eawade7/Death_Ray_OSU_Capstone/README.md

# Death_Ray_OSU_Capstone

Demonstration Videos
https://youtu.be/gTWwTbxBq3s

Explanation of Engineering Specifications
https://youtu.be/X_xn40_CjBk
