eawade7/Death_Ray_OSU_Capstone/Pictures/Copy of 20221027_112926.jpg

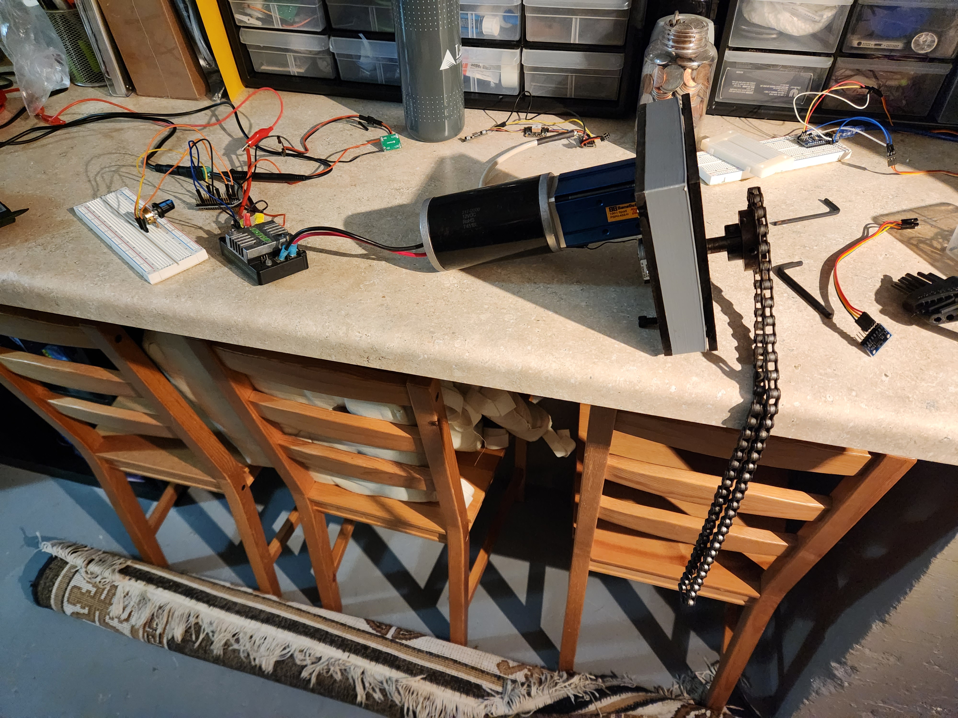
Pictures/Copy of 20221027_112926.jpg
