eawade7/Death_Ray_OSU_Capstone/Pictures/Copy of 20221205_194728.jpg

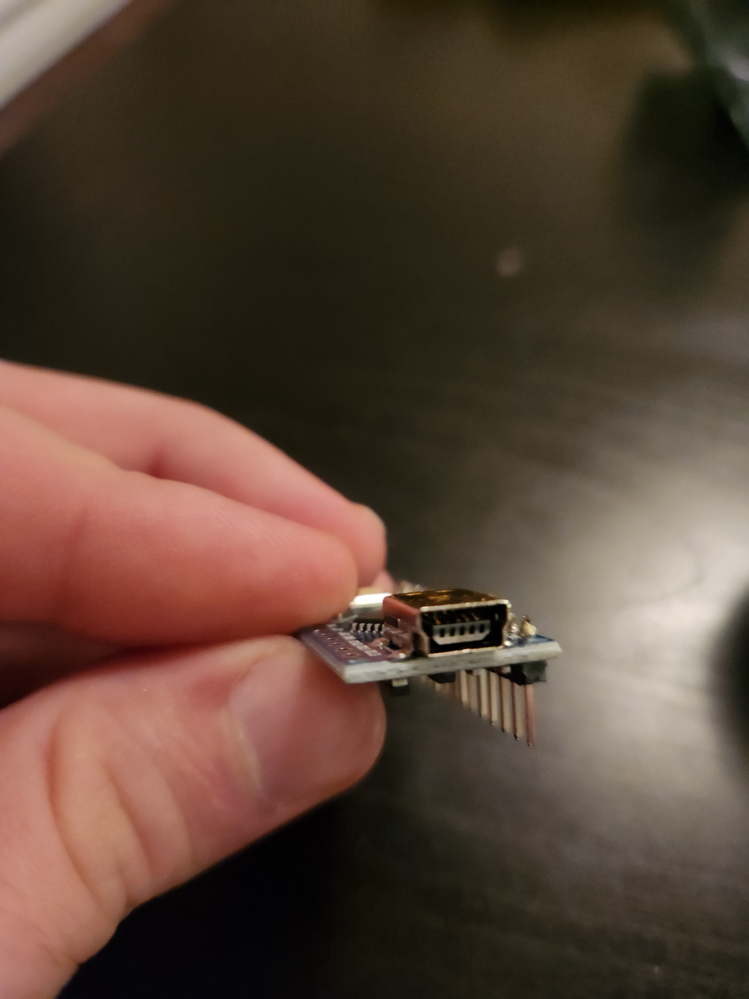
Pictures/Copy of 20221205_194728.jpg
