eawade7/Death_Ray_OSU_Capstone/Pictures/Copy of 20221206_010354.jpg

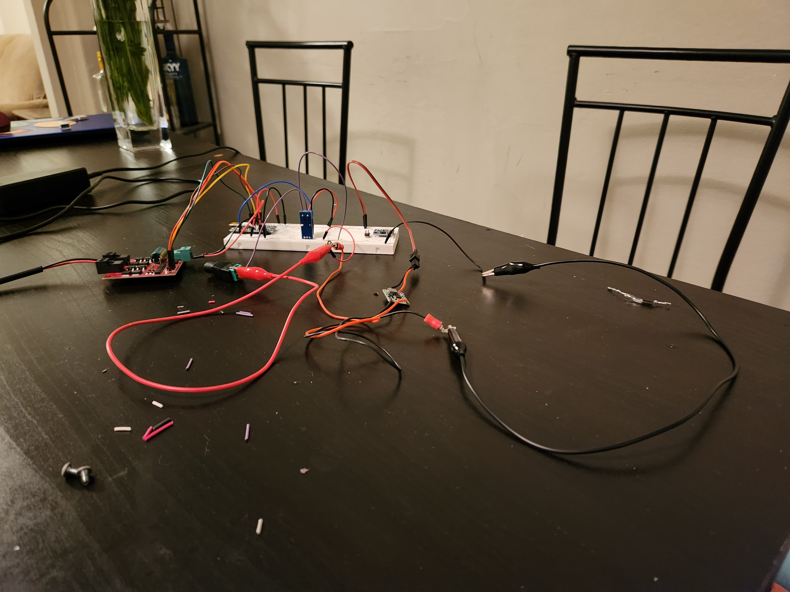
Pictures/Copy of 20221206_010354.jpg
