eawade7/Death_Ray_OSU_Capstone/Pictures/Copy of 20230210_131838.jpg

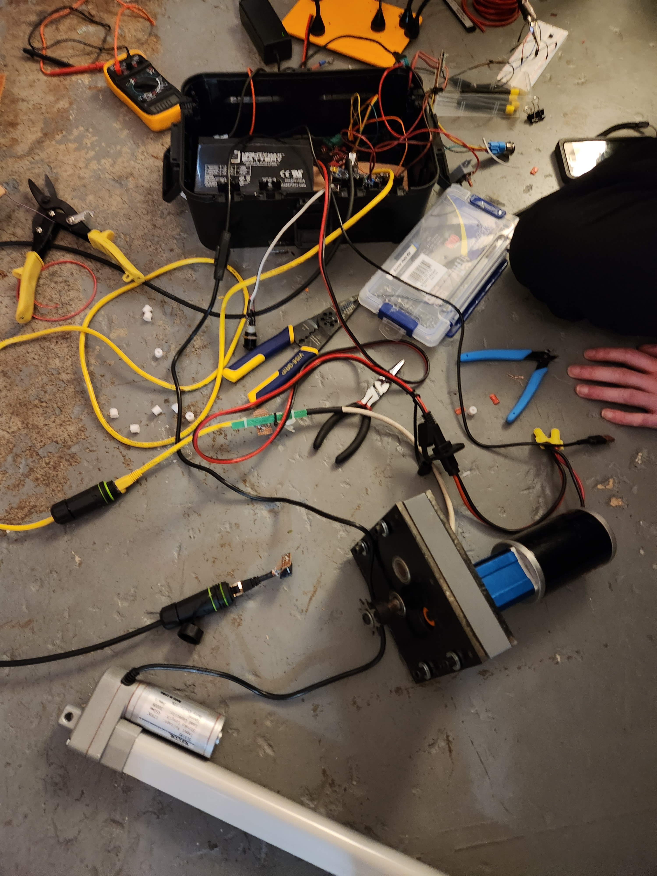
Pictures/Copy of 20230210_131838.jpg
