eawade7/Death_Ray_OSU_Capstone/Pictures/Copy of 20230301_172952.jpg

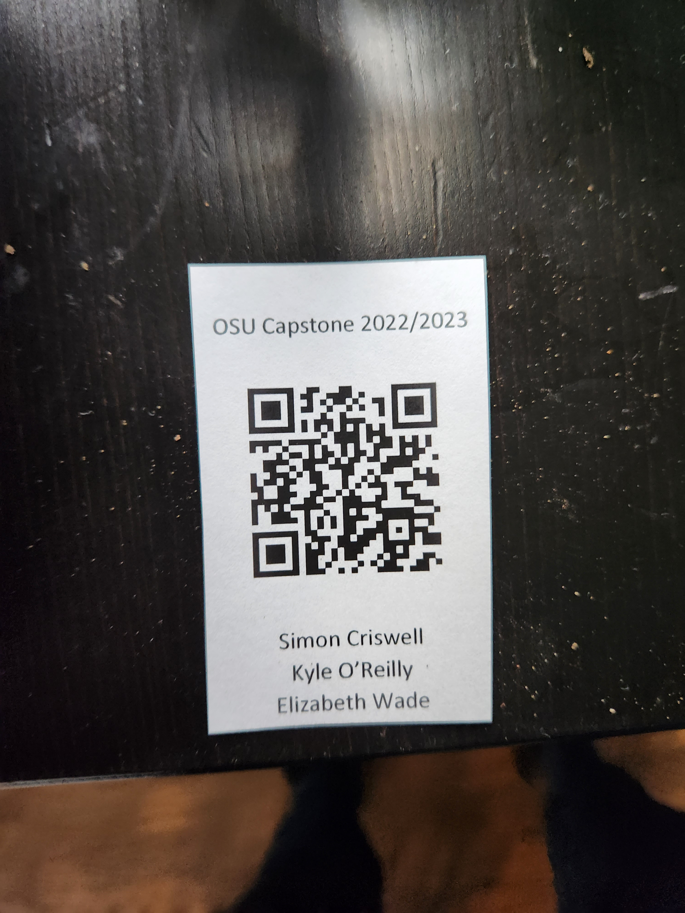
Pictures/Copy of 20230301_172952.jpg
