eawade7/Death_Ray_OSU_Capstone/Pictures/Copy of Screenshot_20221130_054740.png

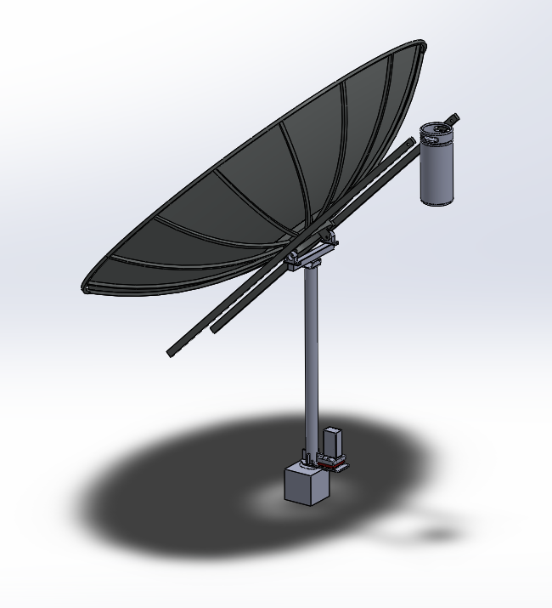
Pictures/Copy of Screenshot_20221130_054740.png
