eawade7/Death_Ray_OSU_Capstone/Pictures/Copy of Screenshot_20221130_102814.png

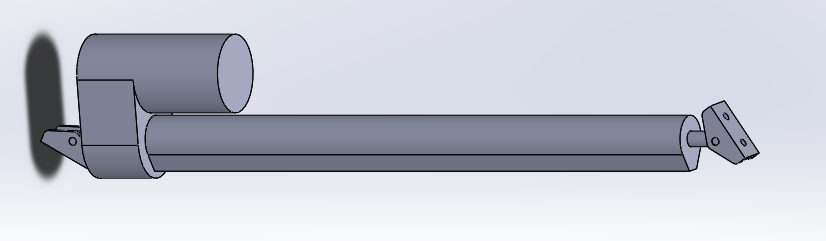
Pictures/Copy of Screenshot_20221130_102814.png
