eawade7/Death_Ray_OSU_Capstone/Final Bill of Materials.xlsx

Full Project BOM
No. | Project Block | Old vs. New Capstone | Item Name | Qty | Vendor | Link | Price per Unit | Total Cost
1 | Tilt | New | Heavy Duty 3000N/660lbs Linear Actuator | 1 | Amazon | Recoil Link (https://www.amazon.com/RECOIL-Actuator-Mounting-Reversing-Momentary/dp/B09BCN81G8) | 66 | 66
2 | Tilt | New | Actuator controller | 1 | Amazon | Linear Actuator Controller (https://www.amazon.com/dp/B071NQ5G71?psc=1&smid=A298K45OP416LP&ref_=chk_typ_imgToDp) | 17 | 17
3 | Power | Old | Battery | 1 | N/A | N/A |  | 0
4 | Comp | New | Accelerometer/Compass chip | 1 | Amazon | Accelerometer Link (https://www.amazon.com/AITRIP-LSM303DLHC-Compass-Acceleration-Magnetometer/dp/B09YQWXK16) | 9.99 | 9.99
5 | Comp | New | Arduino | 1 | AliExpress | Arduino Link (https://www.aliexpress.us/item/2255799923112796.html?curPageLogUid=DR0uJFqDSp4T) | 35 | 35
6 | Comp | New | Current Measuring Device | 1 | Amazon | Current Measuring Link (https://www.amazon.com/HiLetgo-ACS712-Current-Sensor-Module/dp/B07SPRL8DL?s=industrial) | 7.39 | 7.39
7 | Testing | New | Multimeter | 1 | Amazon | Multimeter Link (https://www.amazon.com/dp/B01ISAMUA6?psc=1&smid=A2NOFZGOKNP3PJ&ref_=chk_typ_imgToDp) | 12.99 | 12.99
8 | Tilt/Pan | New | Dual Motor Controller | 1 | Amazon | Motor Controller Link (https://www.amazon.com/DROK-Controller-Regulator-Industrial-Optocoupler/dp/B06XGD5SCB) | 15.78 | 15.78
9 | Power | New | Self-Resetting Fuse | 1 | Amazon | Self-Reseting Fuse Link (https://www.amazon.com/gp/product/B08P6Z5FZJ/ref=ox_sc_act_title_4?smid=A2ZNPLJCY5BQIU&th=1) | 10.97 | 10.97
10 | Power | New | Toggle Switch | 1 | Amazon | Toggle Switch Link (https://www.amazon.com/gp/product/B07QNPTXSW/ref=ox_sc_act_title_1?smid=A86AD06S3OMVQ&psc=1) | 8.99 | 8.99
11 | Comp | New | Push Button | 1 | Amazon | Push Button Link (https://www.amazon.com/gp/product/B07JH9DKLQ/ref=ox_sc_act_title_2?smid=A1792RTTLO6S27&psc=1) | 7.99 | 7.99
12 | Pan | Old | Motor | 1 | N/A | N/A |  | 0
13 | Pan | Old | Motor Controller | 1 | N/A | N/A |  | 0
14 | Power | Old | Voltage Regulator | 1 | N/A | N/A |  | 0
15 | Comp | Old | GPS computer chip | 1 | N/A | N/A |  | 0
16 | Comp | Old | Data Storage computer chip | 1 | N/A | N/A |  | 0
17 | Pan | Old | Encoder | 1 | N/A | N/A |  | 0
18 | Pan | New | small gear | 1 | Mcmaster | Roller Chain Sprocket, for ANSI 41 Chain, 8 Teeth, for 1/2" Shaft Diameter | McMaster-Carr (https://www.mcmaster.com/2737T93/) | 22.7 | 22.7
19 | Power | New | Enclosure | 1 | Amazon | Link (https://www.amazon.com/cart/smart-wagon?newItems=4745eed2-cb6d-4a0e-9c97-382a352b51a4,1) | 26.99 | 26.99
20 | Power | New | Ethernet Coupler | 1 | Amazon | Link (https://www.amazon.com/gp/product/B08CDD2BRF/ref=ox_sc_act_title_2?smid=A3CX0D8X6MF77E&psc=1) | 13.99 | 13.99
21 | Power | New | Ethernet Cord | 1 | Amazon | Link (https://www.amazon.com/gp/product/B07QLXC6QR/ref=ewc_pr_img_1?smid=A2WC0H630DY40C&th=1) | 8.99 | 8.99
22 | Power | New | Solar Module | 1 | Amazon | Link (https://www.amazon.com/gp/product/B07K687B2D/ref=ox_sc_act_title_1?smid=A2EH5PO307BR7O&psc=1) | 33.5 | 33.5
23 | Power | New | wire nut | 1 | home depot | - | 3.98 | 3.98
24 | Power | New | 5/8 drill bit | 1 | home depot | - | 9.97 | 9.97
25 | Pan | New | PETG filament | 1 | Amazon | Link (https://www.amazon.com/HATCHBOX-3D-Filament-Dimensional-Accuracy/dp/B014VM991I) | 24.99 | 24.99
26 | Misc | New | wires | 1 | Amazon | Link (https://www.amazon.com/TUOFENG-Hookup-Wires-6-Different-Colored/dp/B07TX6BX47) | 14.99 | 14.99
27 | Power | New | Trickle Charger | 1 | Amazon | Link (https://www.amazon.com/dp/B07CZ7KWP3?psc=1&smid=A2KZI50HSCBYG9&ref_=chk_typ_imgToDp) | 17.96 | 17.96
 |  |  |  |  |  |  | Total | 353.16
