eawade7/Death_Ray_OSU_Capstone/Wiring_Diagram.pdf

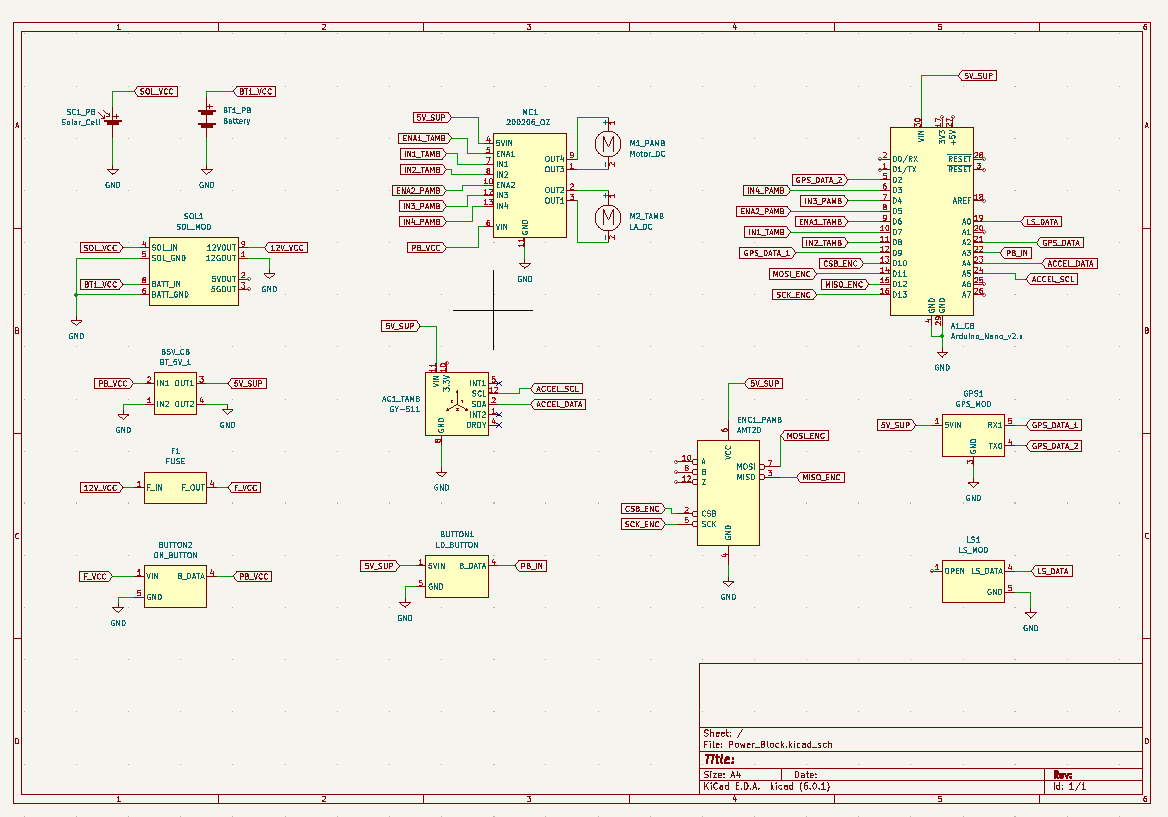
[picture p74: page 1]
