eawade7/Death_Ray_OSU_Capstone/NEW_GENERAL_DOC_DeathRayDrawing_02.pdf

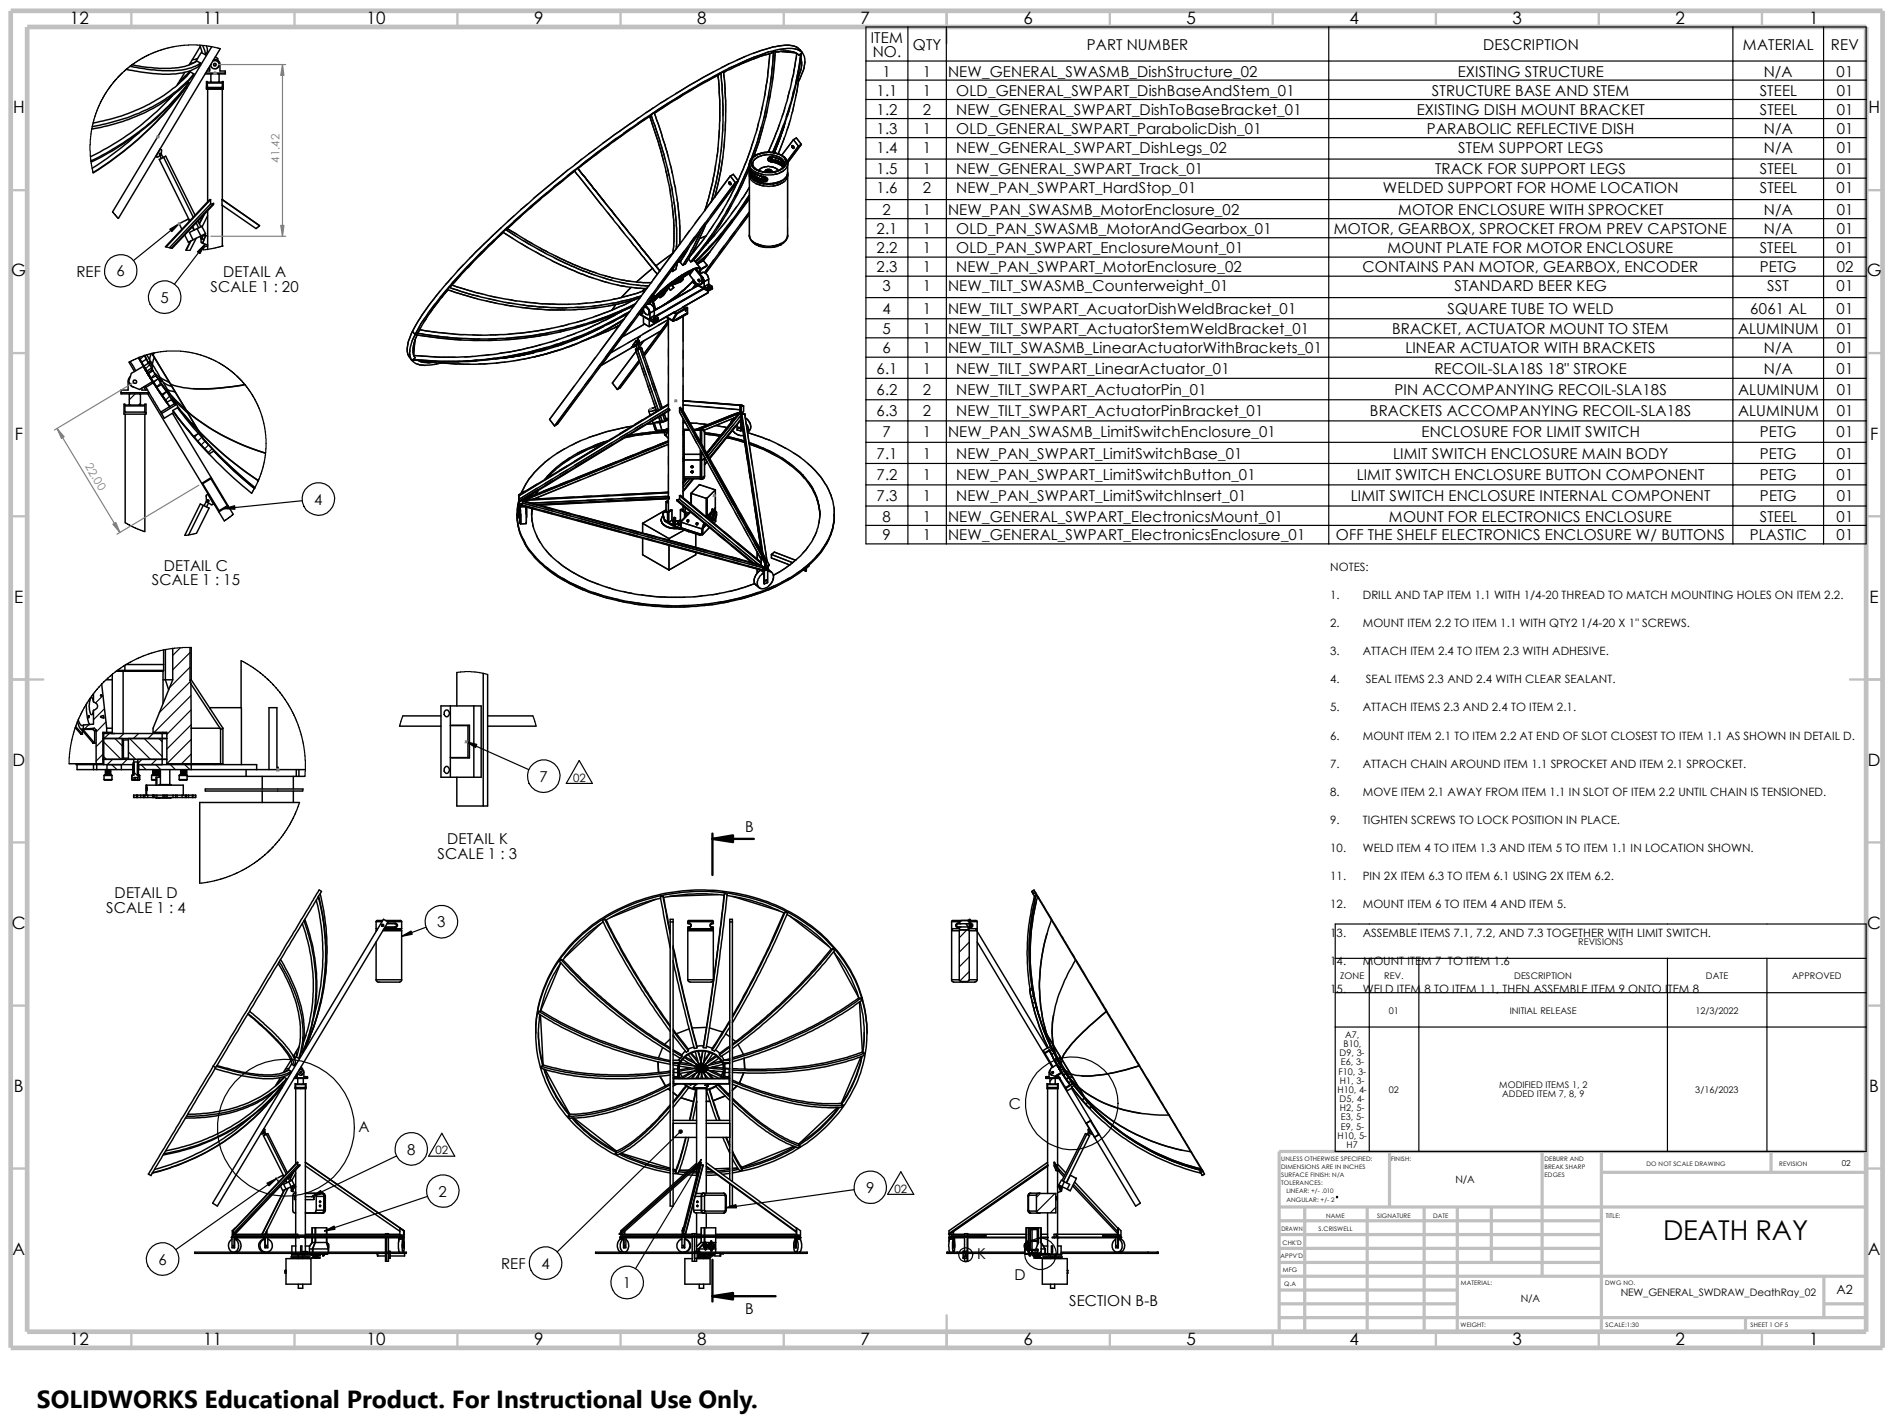
[picture p75: page 1]
FINISH:; DEBURR AND; BREAK SHARP EDGES; DO NOT SCALE DRAWING; REVISION; SCALE:1:30; SHEET 1 OF 5; WEIGHT:; DETAIL A SCALE 1 : 20; REF 6; SECTION B-B; ITEM; NO. QTY; PART NUMBER; DESCRIPTION; MATERIAL REV; 1 NEW_GENERAL_SWASMB_DishStructure_02; EXISTING STRUCTURE; OLD_GENERAL_SWPART_DishBaseAndStem_01; STRUCTURE BASE AND STEM; STEEL; NEW_GENERAL_SWPART_DishToBaseBracket_01; EXISTING DISH MOUNT BRACKET; OLD_GENERAL_SWPART_ParabolicDish_01; PARABOLIC REFLECTIVE DISH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

1. DRILL AND TAP ITEM 1.1 WITH 1/4-20 THREAD TO MATCH MOUNTING HOLES ON ITEM 2.2.

2. MOUNT ITEM 2.2 TO ITEM 1.1 WITH QTY2 1/4-20 X 1" SCREWS.

3. ATTACH ITEM 2.4 TO ITEM 2.3 WITH ADHESIVE.

4. SEAL ITEMS 2.3 AND 2.4 WITH CLEAR SEALANT.

5. ATTACH ITEMS 2.3 AND 2.4 TO ITEM 2.1.

6. MOUNT ITEM 2.1 TO ITEM 2.2 AT END OF SLOT CLOSEST TO ITEM 1.1 AS SHOWN IN DETAIL D.

7. ATTACH CHAIN AROUND ITEM 1.1 SPROCKET AND ITEM 2.1 SPROCKET.

8. MOVE ITEM 2.1 AWAY FROM ITEM 1.1 IN SLOT OF ITEM 2.2 UNTIL CHAIN IS TENSIONED.

9. TIGHTEN SCREWS TO LOCK POSITION IN PLACE.

10. WELD ITEM 4 TO ITEM 1.3 AND ITEM 5 TO ITEM 1.1 IN LOCATION SHOWN.

11. PIN 2X ITEM 6.3 TO ITEM 6.1 USING 2X ITEM 6.2.

12. MOUNT ITEM 6 TO ITEM 4 AND ITEM 5.

13. ASSEMBLE ITEMS 7.1, 7.2, AND 7.3 TOGETHER WITH LIMIT SWITCH.

14. MOUNT ITEM 7 TO ITEM 1.6
15. WELD ITEM 8 TO ITEM 1.1, THEN ASSEMBLE ITEM 9 ONTO ITEM 8

UNLESS OTHERWISE SPECIFIED:
DIMENSIONS ARE IN INCHES
SURFACE FINISH: N/A
TOLERANCES:
LINEAR: +/- .010
ANGULAR: +/- 2

NAME | SIGNATURE | DATE | | | | TITLE: DEATH RAY

DRAWN | S.CRISWELL
CHK'D
APPV'D

MFG
Q.A | | | | MATERIAL: | DWG NO. NEW_GENERAL_SWDRAW_DeathRay_02 | A2 N/A

SOLIDWORKS Educational Product. For Instructional Use Only.

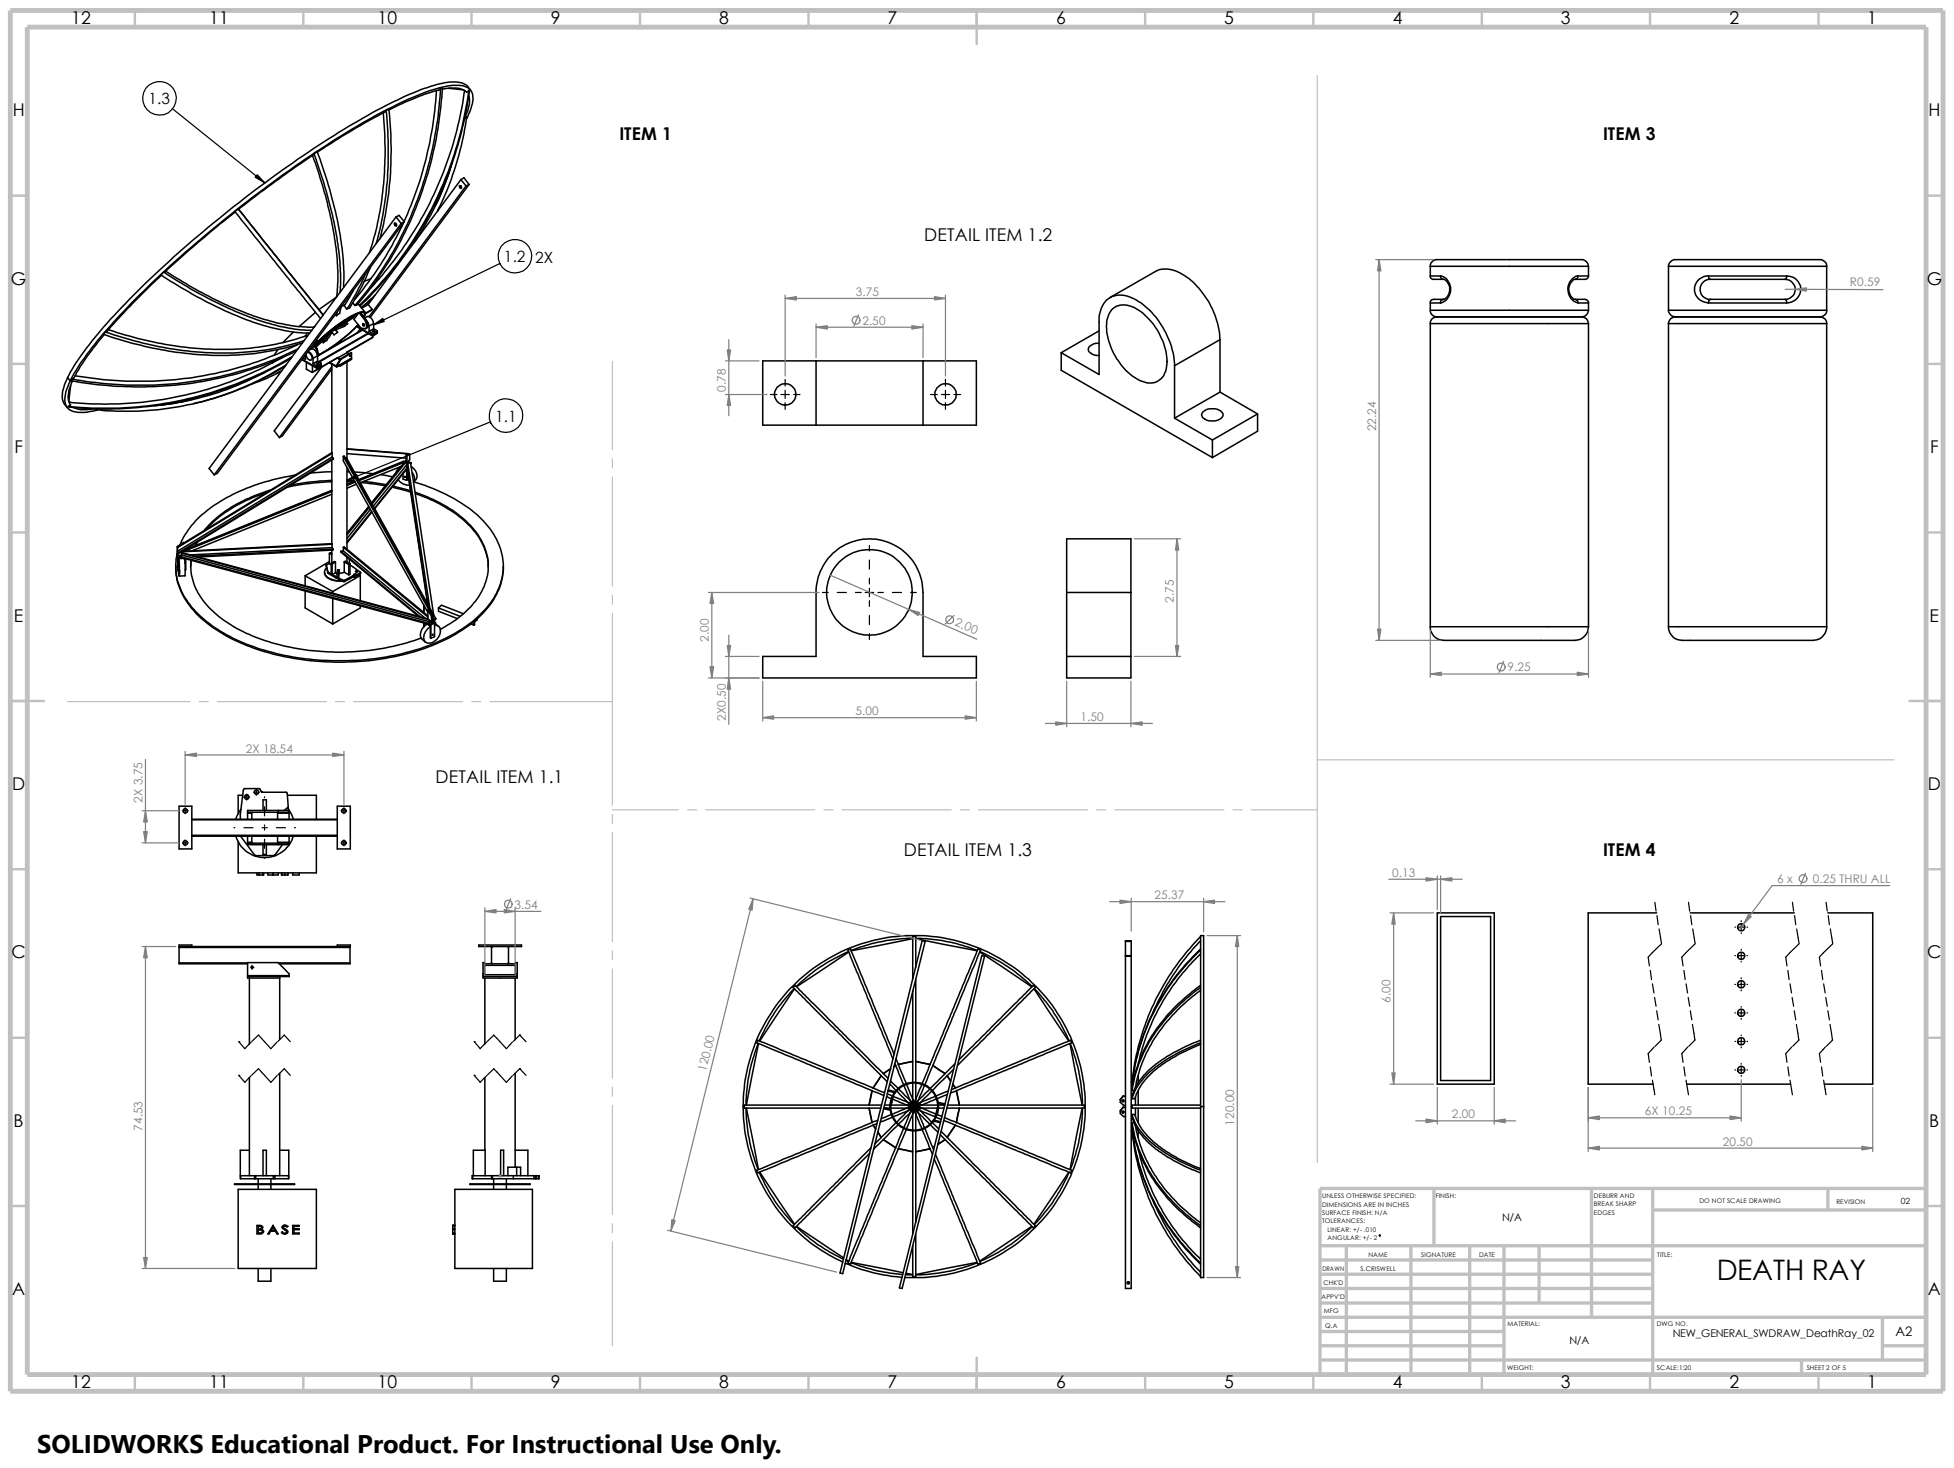
[picture p76: page 2]
FINISH:; DEBURR AND; BREAK SHARP EDGES; DO NOT SCALE DRAWING; REVISION; SCALE:1:20; SHEET 2 OF 5; ITEM 1; DETAIL ITEM 1.1; DETAIL ITEM 1.3; DETAIL ITEM 1.2; ITEM 3; ITEM 4; 0.25 THRU ALL

UNLESS OTHERWISE SPECIFIED:
DIMENSIONS ARE IN INCHES
SURFACE FINISH: N/A
TOLERANCES:
LINEAR: +/- .010
ANGULAR: +/- 2

NAME | SIGNATURE | DATE | | | | TITLE: DEATH RAY

DRAWN | S.CRISWELL
CHK'D
APPV'D

MFG
Q.A | | | | MATERIAL: | DWG NO. NEW_GENERAL_SWDRAW_DeathRay_02 | A2 N/A

M 7.19

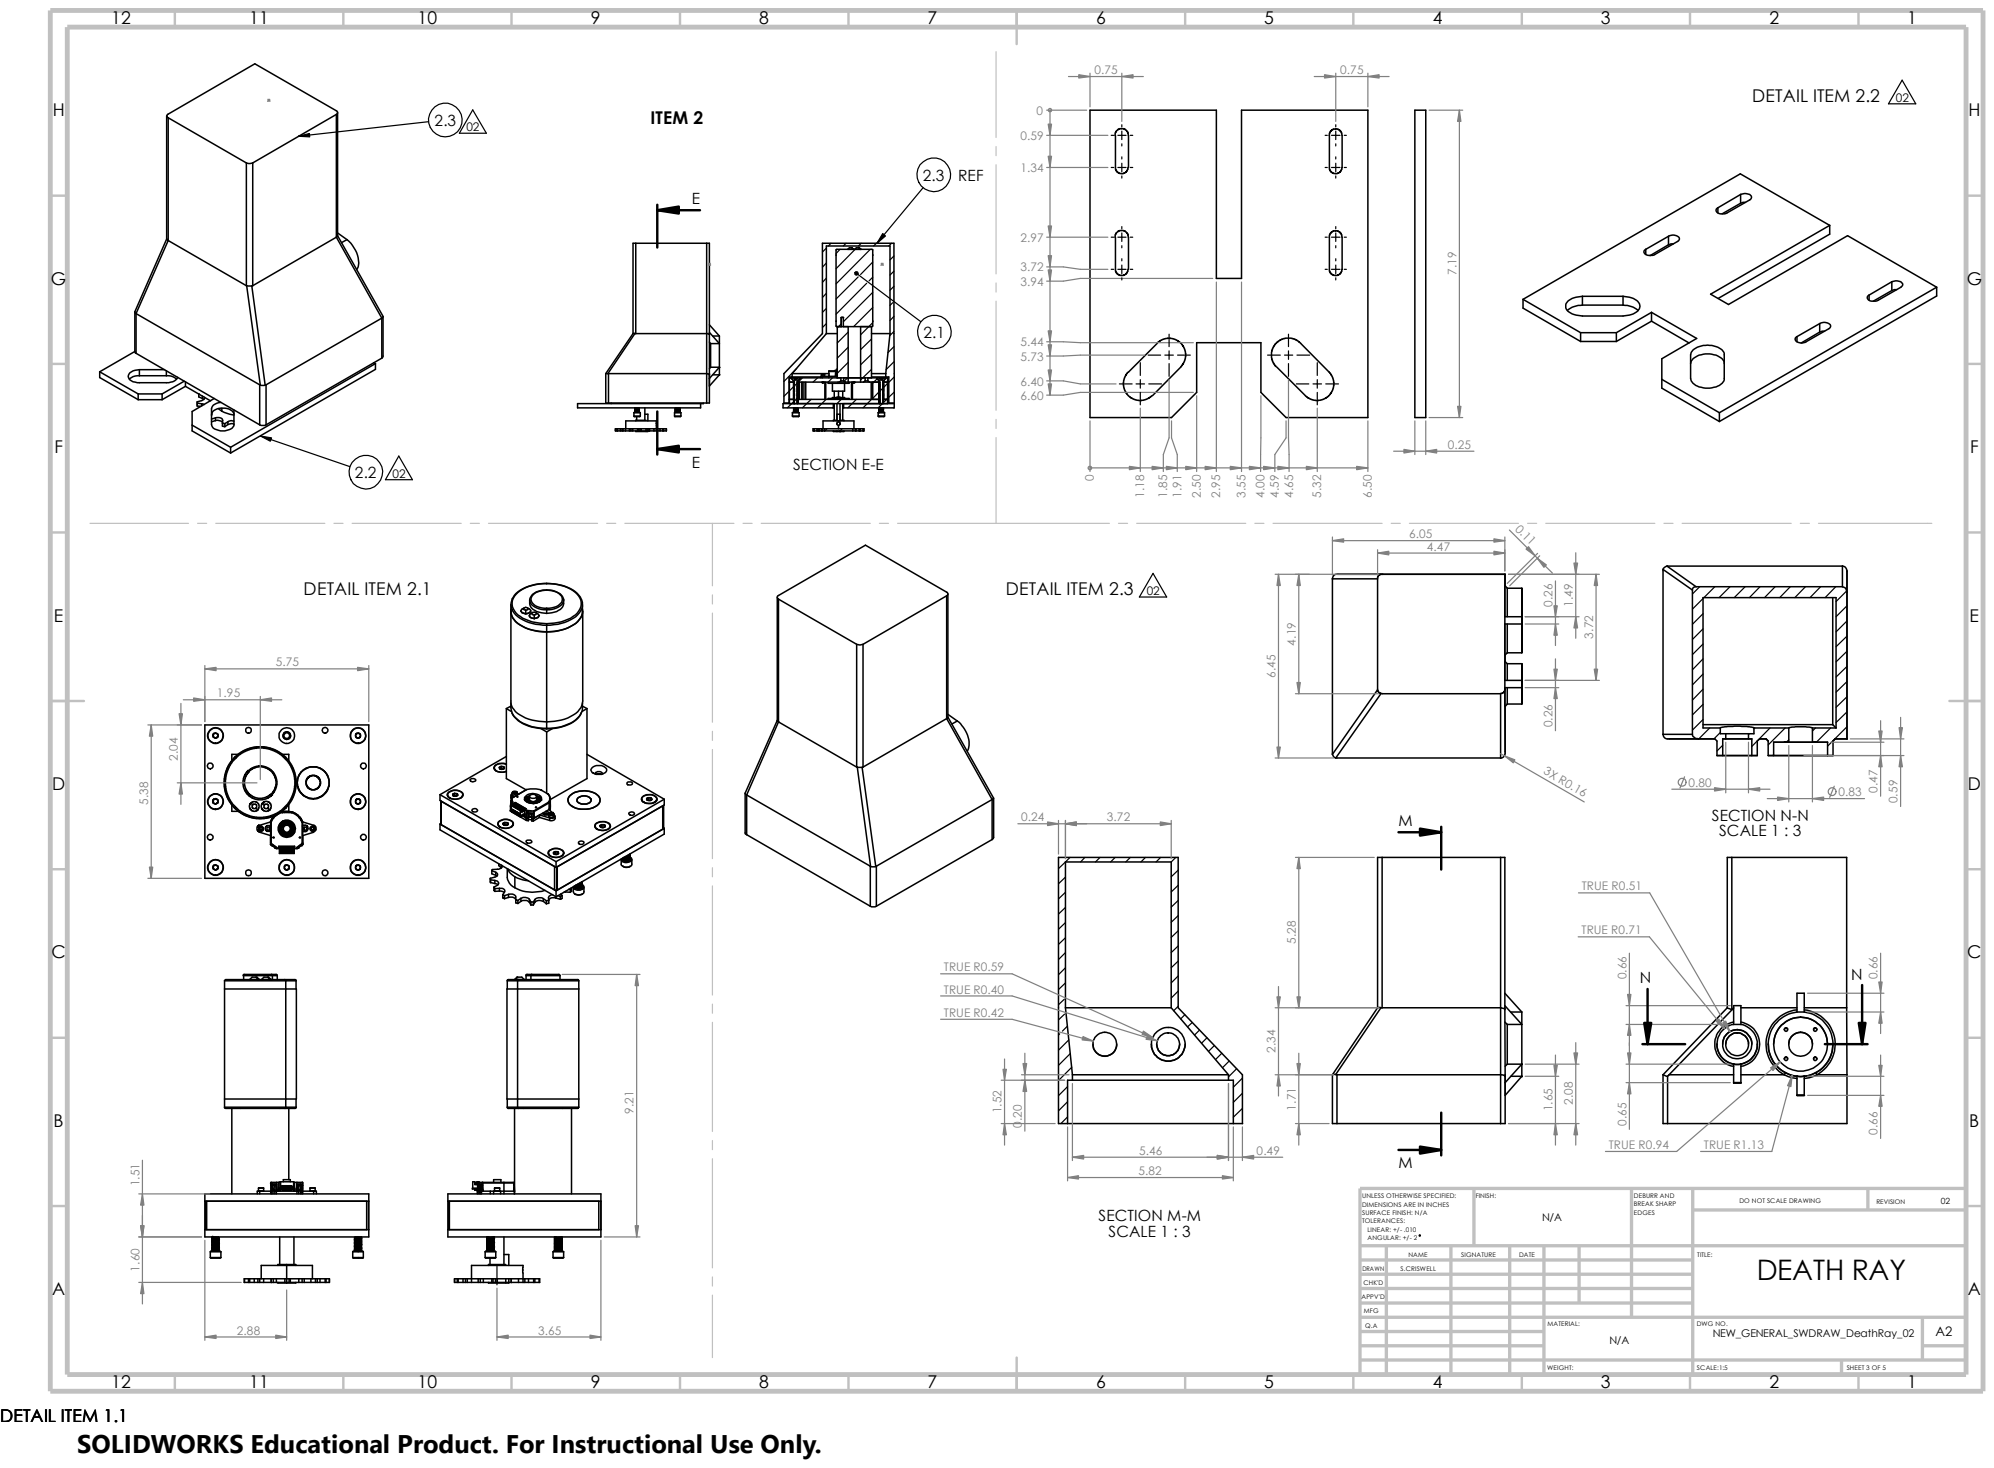
[picture p77: page 3]
6.50 DRAWN; FINISH:; DEBURR AND; BREAK SHARP EDGES; DO NOT SCALE DRAWING; REVISION; SCALE:1:5; SHEET 3 OF 5; ITEM 2; DETAIL ITEM 1.1; DETAIL ITEM 2.1; DETAIL ITEM 2.2; DETAIL ITEM 2.3; SECTION N-N SCALE 1 : 3; SECTION M-M SCALE 1 : 3; TRUE R0.42; TRUE R0.40; TRUE R0.59; TRUE R0.94; TRUE R1.13; TRUE R0.71; TRUE R0.51; SECTION E-E; 2.3 REF

UNLESS OTHERWISE SPECIFIED:
DIMENSIONS ARE IN INCHES
SURFACE FINISH: N/A
TOLERANCES:
LINEAR: +/- .010
ANGULAR: +/- 2

NAME | SIGNATURE | DATE | | | | TITLE: DEATH RAY
S.CRISWELL

CHK'D
APPV'D

MFG
Q.A | | | | MATERIAL: | DWG NO. NEW_GENERAL_SWDRAW_DeathRay_02 | A2 N/A

6.3 2X 10.00

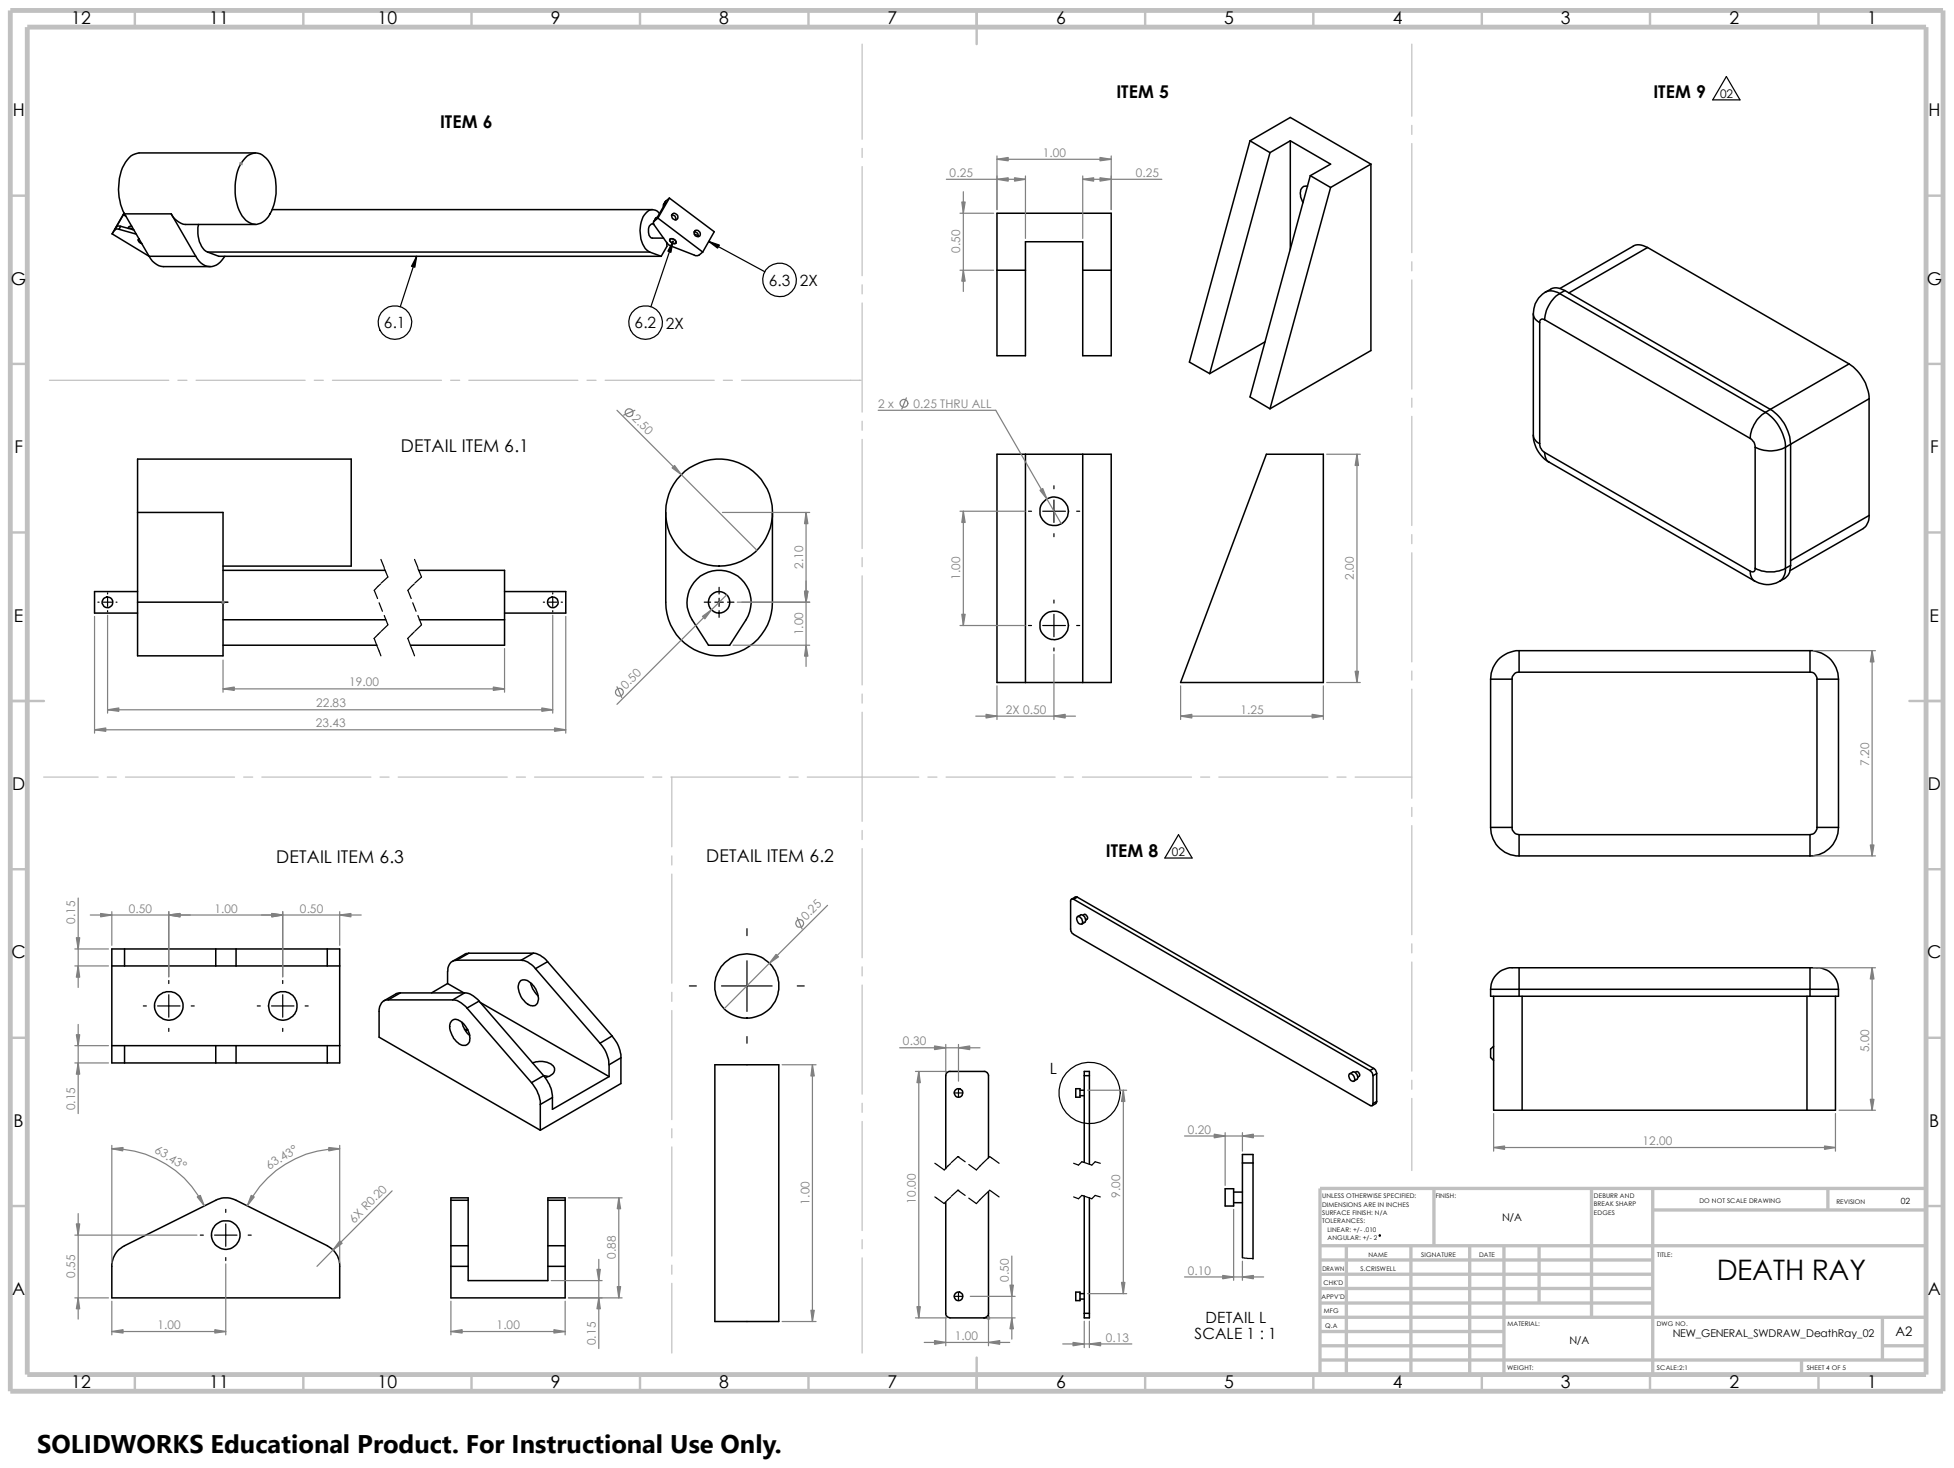
[picture p78: page 4]
FINISH:; DEBURR AND; BREAK SHARP EDGES; MATERIAL:; DO NOT SCALE DRAWING; REVISION; DWG NO.; SCALE:2:1; SHEET 4 OF 5; NEW_GENERAL_SWDRAW_DeathRay_02; 0.25 THRU ALL; ITEM 5; ITEM 6; DETAIL ITEM 6.1; DETAIL ITEM 6.3; DETAIL ITEM 6.2; ITEM 9 02 2.00; ITEM 8 02; DETAIL L SCALE 1 : 1

UNLESS OTHERWISE SPECIFIED:
DIMENSIONS ARE IN INCHES
SURFACE FINISH: N/A
TOLERANCES:
LINEAR: +/- .010
ANGULAR: +/- 2

NAME | SIGNATURE | DATE | TITLE: DEATH RAY

DRAWN | S.CRISWELL
CHK'D
APPV'D

MFG

# 7.1 REF 0.08 0.08 0.21 0.21 0.32 0.32

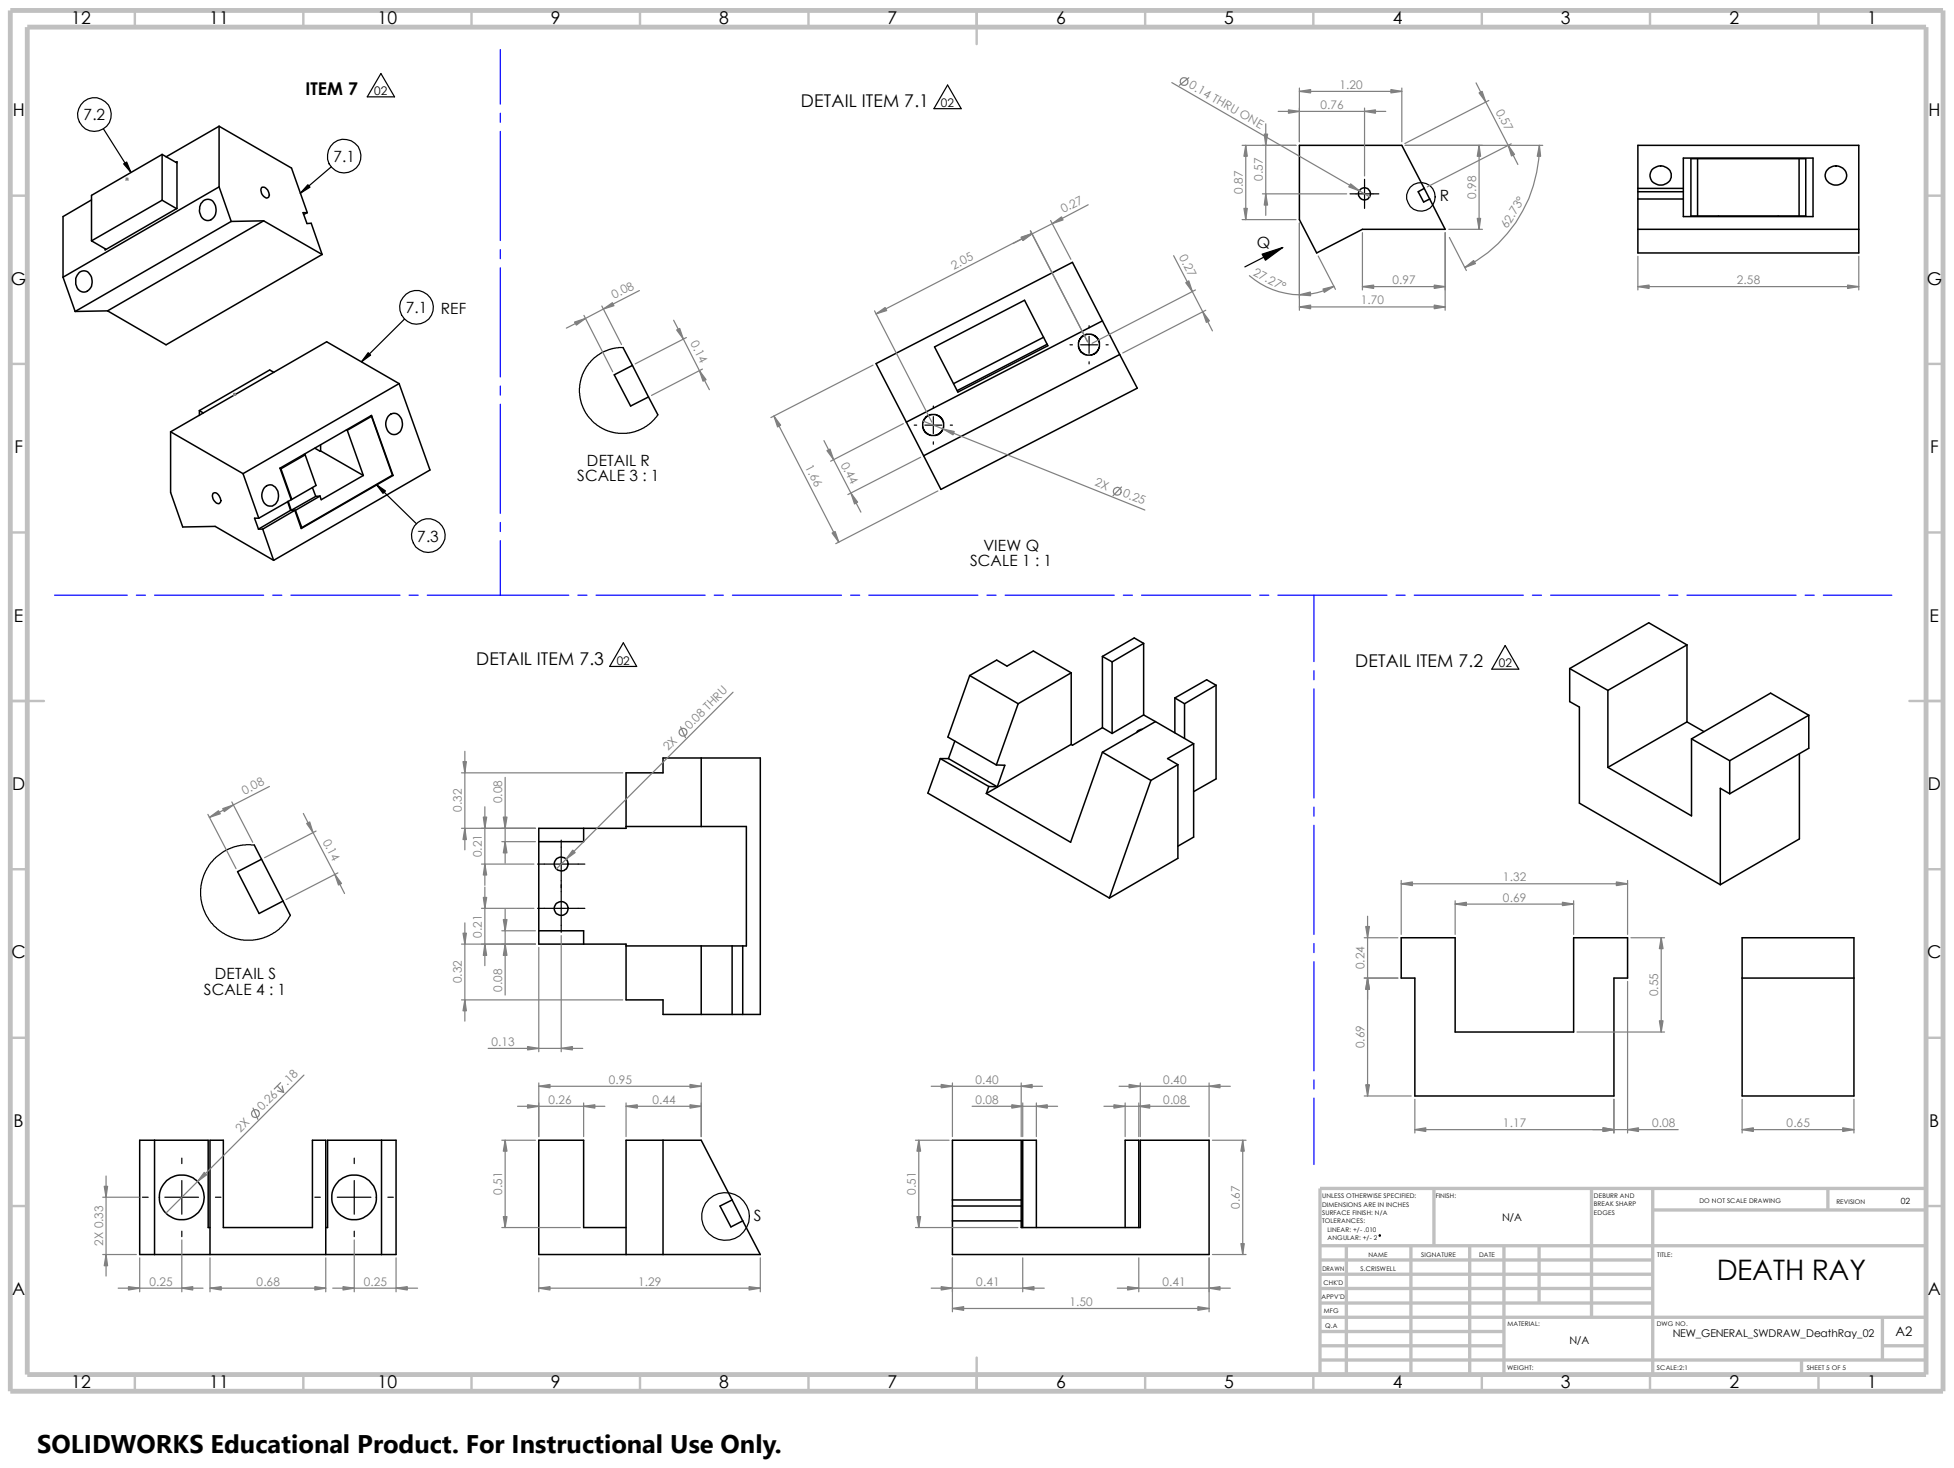
[picture p79: page 5]
DRAWN; FINISH:; DEBURR AND; BREAK SHARP EDGES; NAME; SIGNATURE; DATE; DO NOT SCALE DRAWING; REVISION; TITLE:; SCALE:2:1; SHEET 5 OF 5; S.CRISWELL; DEATH RAY; VIEW Q; SCALE 1 : 1 ¹.6; DETAIL R; SCALE 3 : 1; 0.14 THRU ONE; ITEM 7; DETAIL ITEM 7.1; DETAIL ITEM 7.3 02; DETAIL ITEM 7.2 02; 2X 0.08 THRU; DETAIL S; SCALE 4 : 1 ⁰.08

UNLESS OTHERWISE SPECIFIED:
DIMENSIONS ARE IN INCHES
SURFACE FINISH: N/A
TOLERANCES:
LINEAR: +/- .010
ANGULAR: +/- 2

CHK'D
APPV'D

MFG
Q.A | MATERIAL: | DWG NO. NEW_GENERAL_SWDRAW_DeathRay_02 | A2 N/A
