eawade7/Death_Ray_OSU_Capstone/Power_Block.kicad_sch

## KiCad design Power_Block.kicad_sch (2023-03-19)

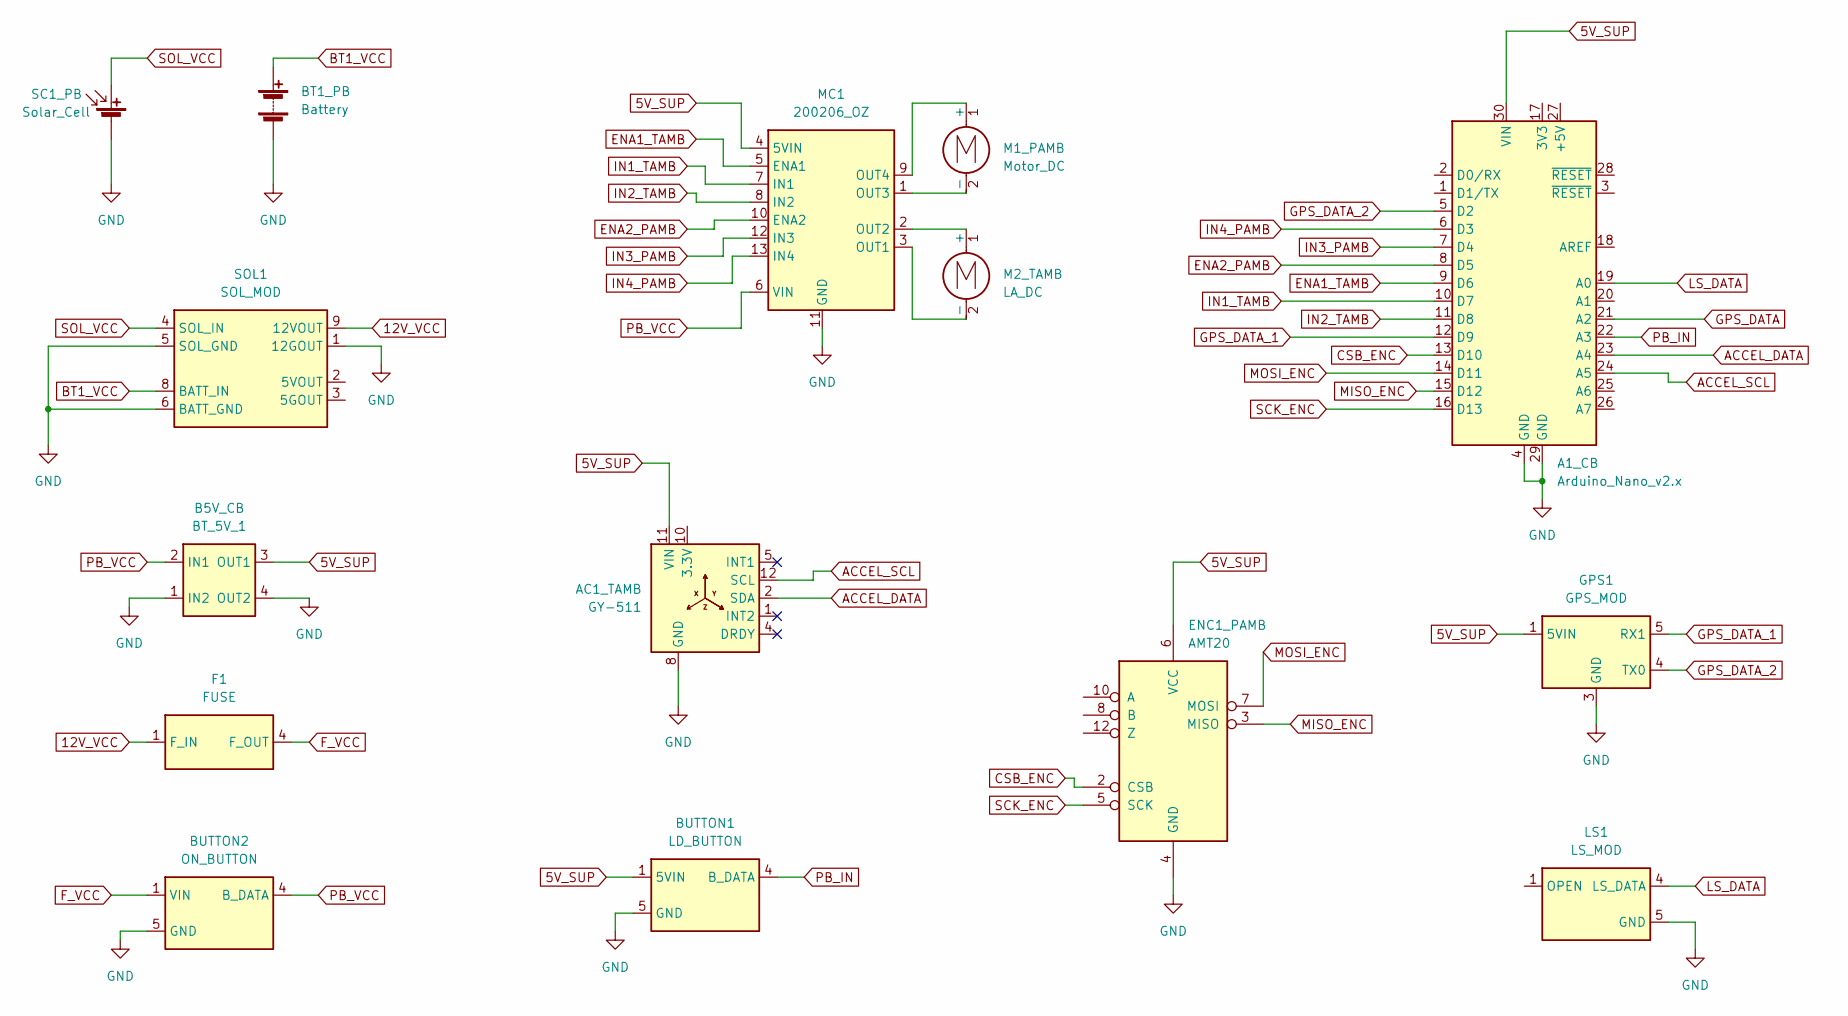
[picture p80: schematic Power_Block.kicad_sch]

Parts:
A1_CB: Arduino_Nano_v2.x; Arduino_Nano
AC1_TAMB: GY-511; Kionix_LGA-12_2x2mm_P0.5mm_LayoutBorder2x4y
B5V_CB: BT_5V_1; Infineon_PG-DSO-8-43
BT1_PB: Battery
BUTTON1: LD_BUTTON
BUTTON2: ON_BUTTON
ENC1_PAMB: AMT20
F1: FUSE
GPS1: GPS_MOD
LS1: LS_MOD
M1_PAMB: Motor_DC
M2_TAMB: LA_DC
MC1: 200206_OZ
SC1_PB: Solar_Cell
SOL1: SOL_MOD

Connections:
5V_SUP: A1_CB.30 (VIN), AC1_TAMB.3 (IO_VDD), AC1_TAMB.11 (VIN), B5V_CB.3 (OUT1), BUTTON1.1 (5VIN), ENC1_PAMB.6 (VCC), GPS1.1 (5VIN), MC1.4 (5VIN)
12V_VCC: F1.1 (F_IN), SOL1.9 (12VOUT)
ACCEL_DATA: A1_CB.23 (A4), AC1_TAMB.2 (SDA)
ACCEL_SCL: A1_CB.24 (A5), AC1_TAMB.12 (SCL)
BT1_VCC: BT1_PB.1 (+), SOL1.8 (BATT_IN)
CSB_ENC: A1_CB.13 (D10), ENC1_PAMB.2 (CSB)
ENA1_TAMB: A1_CB.9 (D6), MC1.5 (ENA1)
ENA2_PAMB: A1_CB.8 (D5), MC1.10 (ENA2)
F_VCC: BUTTON2.1 (VIN), F1.4 (F_OUT)
GPS_DATA: A1_CB.21 (A2)
GPS_DATA_1: A1_CB.12 (D9), GPS1.5 (RX1)
GPS_DATA_2: A1_CB.5 (D2), GPS1.4 (TX0)
IN1_TAMB: A1_CB.10 (D7), MC1.7 (IN1)
IN2_TAMB: A1_CB.11 (D8), MC1.8 (IN2)
IN3_PAMB: A1_CB.7 (D4), MC1.12 (IN3)
IN4_PAMB: A1_CB.6 (D3), MC1.13 (IN4)
LS_DATA: A1_CB.19 (A0), LS1.4 (LS_DATA)
MISO_ENC: A1_CB.15 (D12), ENC1_PAMB.3 (MISO)
MOSI_ENC: A1_CB.14 (D11), ENC1_PAMB.7 (MOSI)
unnamed: A1_CB.4 (GND), A1_CB.29 (GND)
unnamed: AC1_TAMB.7 (VDD), AC1_TAMB.10 (3.3V)
unnamed: M1_PAMB.1 (+), MC1.9 (OUT4)
unnamed: M1_PAMB.2 (-), MC1.1 (OUT3)
unnamed: M2_TAMB.1 (+), MC1.2 (OUT2)
unnamed: M2_TAMB.2 (-), MC1.3 (OUT1)
unnamed: SOL1.5 (SOL_GND), SOL1.6 (BATT_GND)
PB_IN: A1_CB.22 (A3), BUTTON1.4 (B_DATA)
PB_VCC: B5V_CB.2 (IN1), BUTTON2.4 (B_DATA), MC1.6 (VIN)
SCK_ENC: A1_CB.16 (D13), ENC1_PAMB.5 (SCK)
SOL_VCC: SC1_PB.1 (+), SOL1.4 (SOL_IN)
