eawade7/Death_Ray_OSU_Capstone/Pictures/Copy of 20221005_104859.jpg

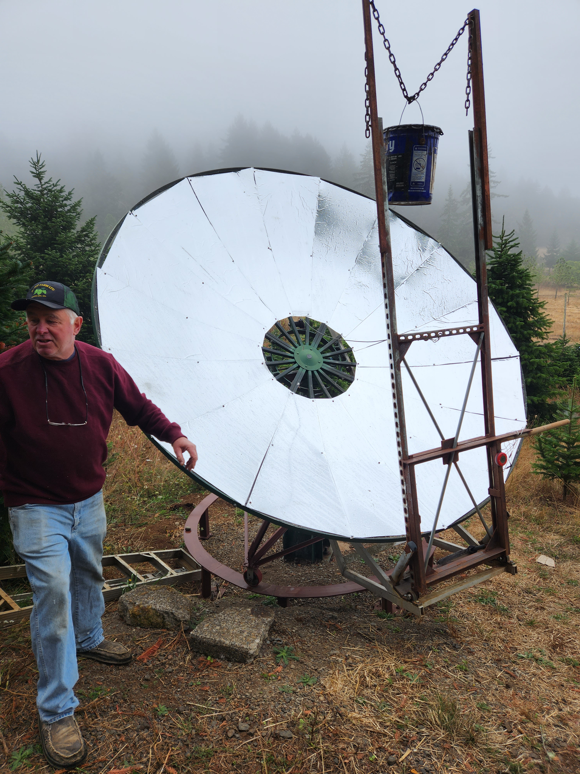
Pictures/Copy of 20221005_104859.jpg
