eawade7/Death_Ray_OSU_Capstone/Pictures/Copy of 20221027_112922.jpg

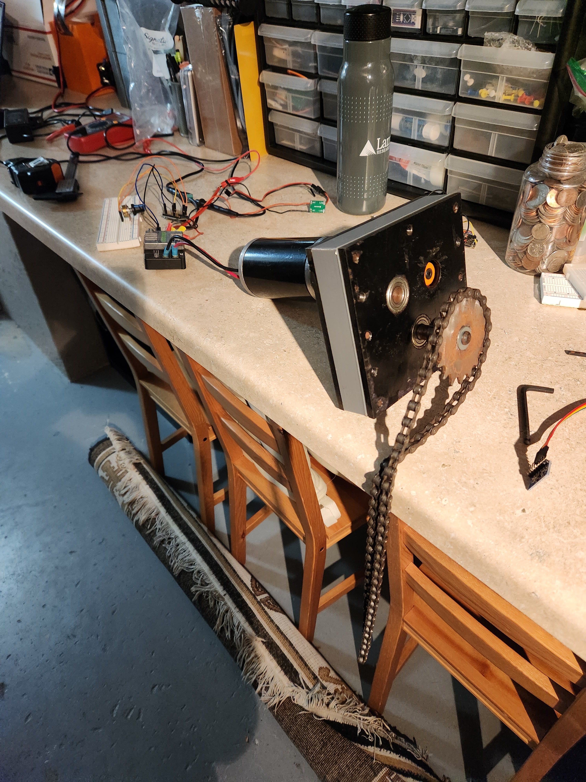
Pictures/Copy of 20221027_112922.jpg
