eawade7/Death_Ray_OSU_Capstone/Pictures/Copy of 20230210_131835.jpg

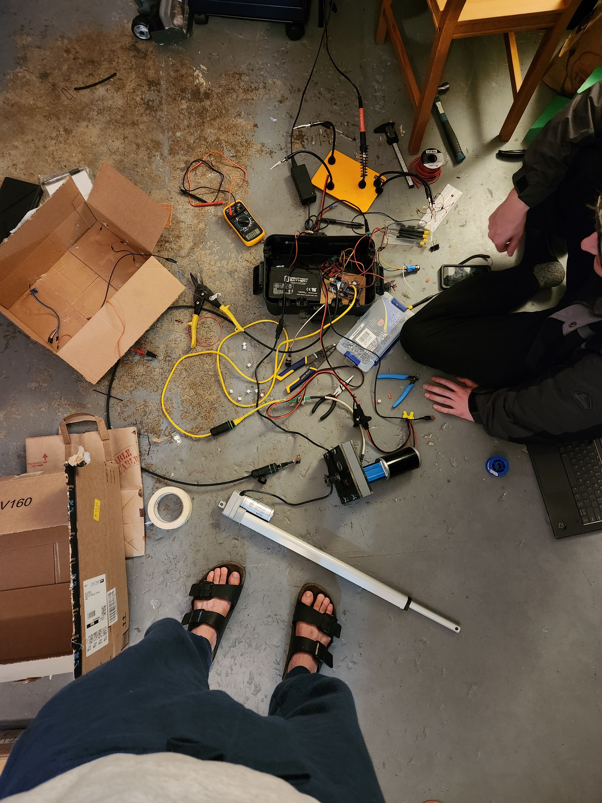
Pictures/Copy of 20230210_131835.jpg
