eawade7/Death_Ray_OSU_Capstone/Pictures/Copy of 20230211_110609.jpg

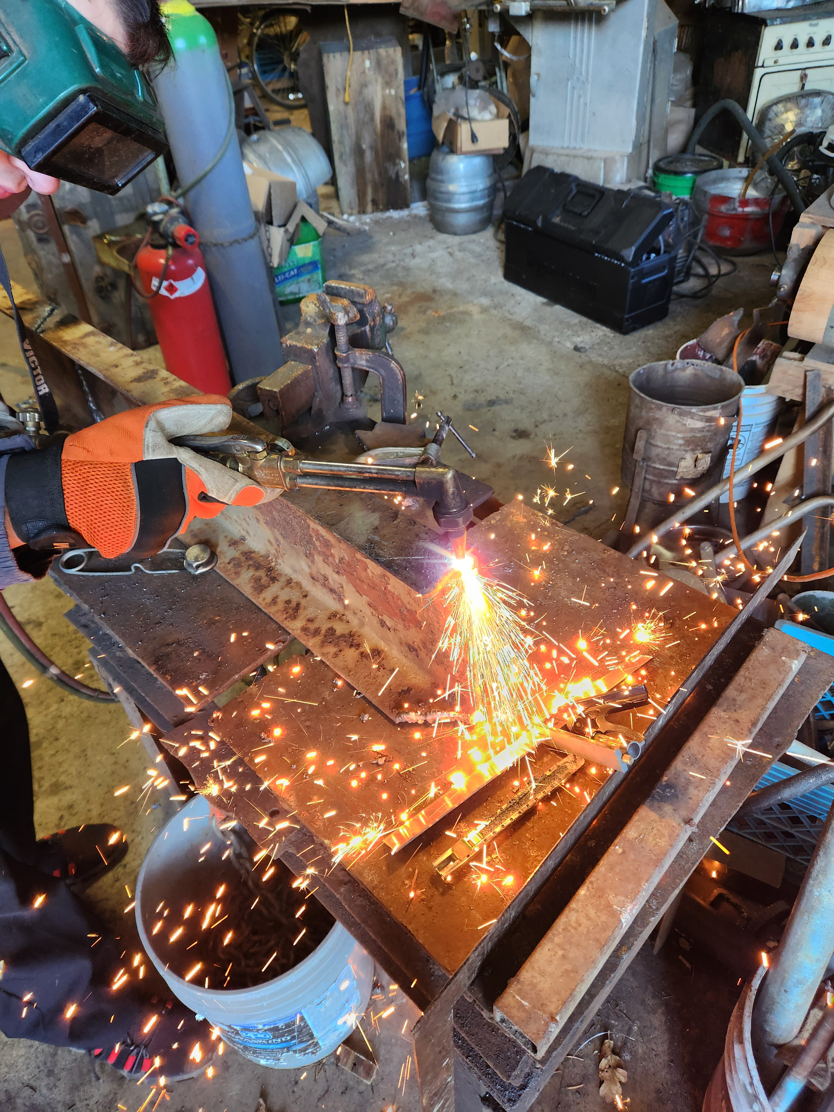
Pictures/Copy of 20230211_110609.jpg
