eawade7/Death_Ray_OSU_Capstone/Pictures/Copy of 20230301_114846.jpg

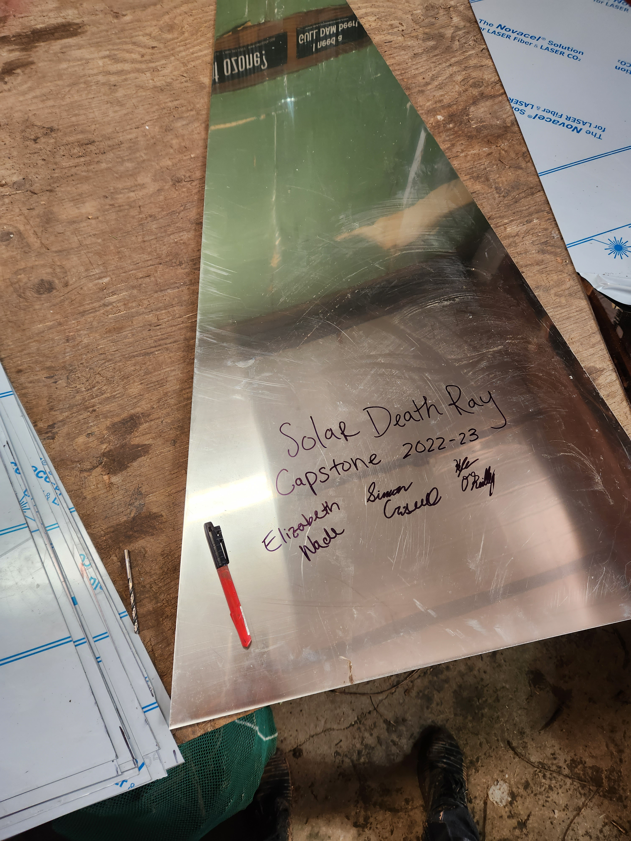
Pictures/Copy of 20230301_114846.jpg
