eawade7/Death_Ray_OSU_Capstone/Pictures/Copy of 20221005_110313.jpg

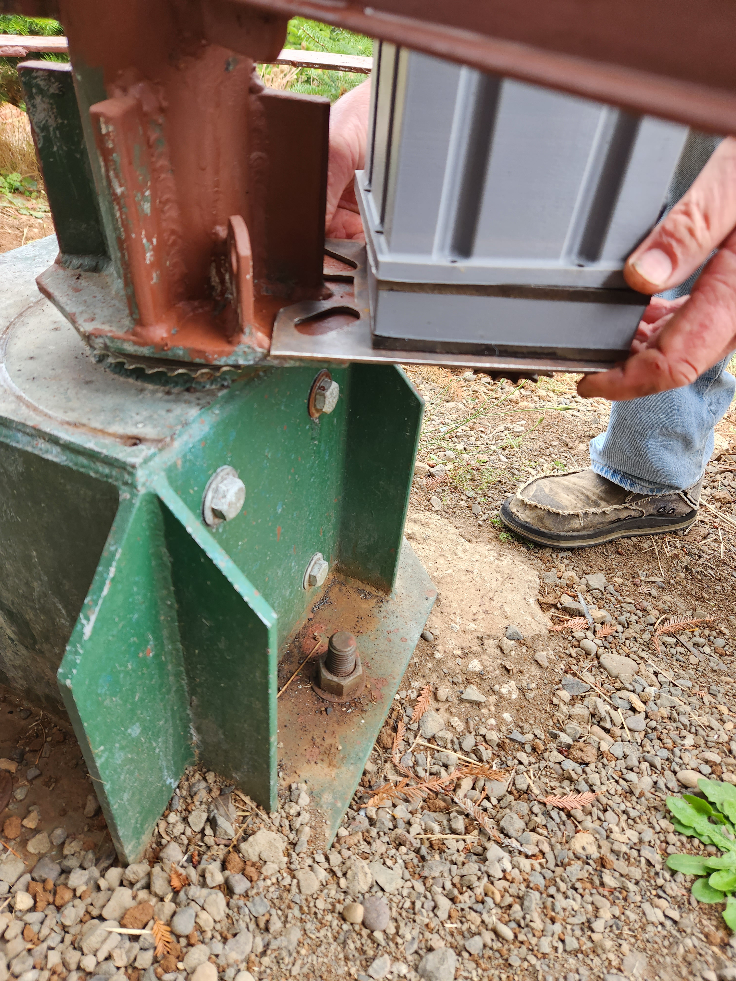
Pictures/Copy of 20221005_110313.jpg
